SS-Electronics/KiCAD_DB/README.md

# KiCAD_DB
KiCAD Symbol and Footprint database.
