SS-Electronics/KiCAD_DB/3D/TS1117BCW50_RPG.step

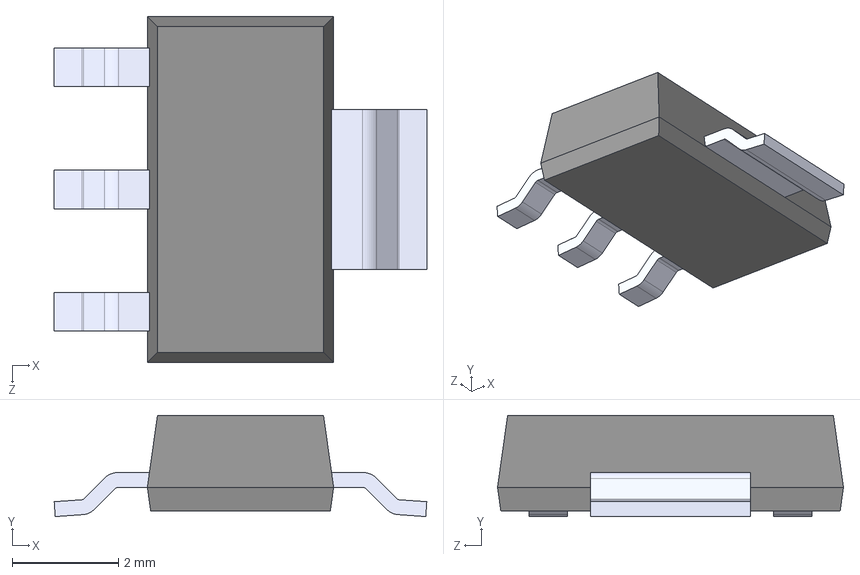
[picture p1: CAD file, 2025-02-05]
3D/TS1117BCW50_RPG.step
7.00 x 1.90 x 6.50 mm
