SS-Electronics/KiCAD_DB/3D/PCF8574ADWR.step

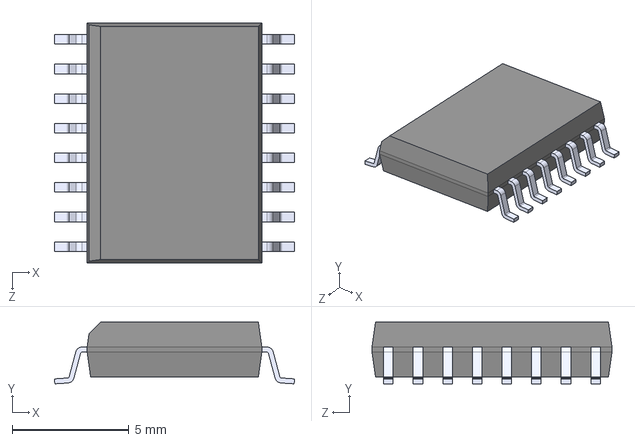
[picture p2: CAD file, 2025-02-03]
3D/PCF8574ADWR.step
10.3 x 2.65 x 10.3 mm
