SS-Electronics/KiCAD_DB/3D/G5LE-14 DC5.STEP

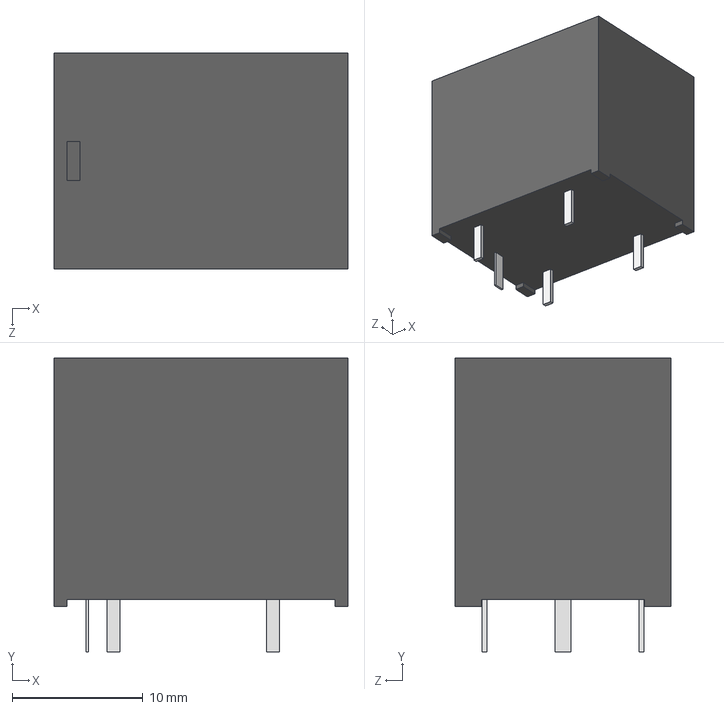
[picture p3: CAD file, 2025-02-03]
3D/G5LE-14 DC5.STEP
22.5 x 22.5 x 16.5 mm
