SS-Electronics/KiCAD_DB/3D/6120XX21621.step

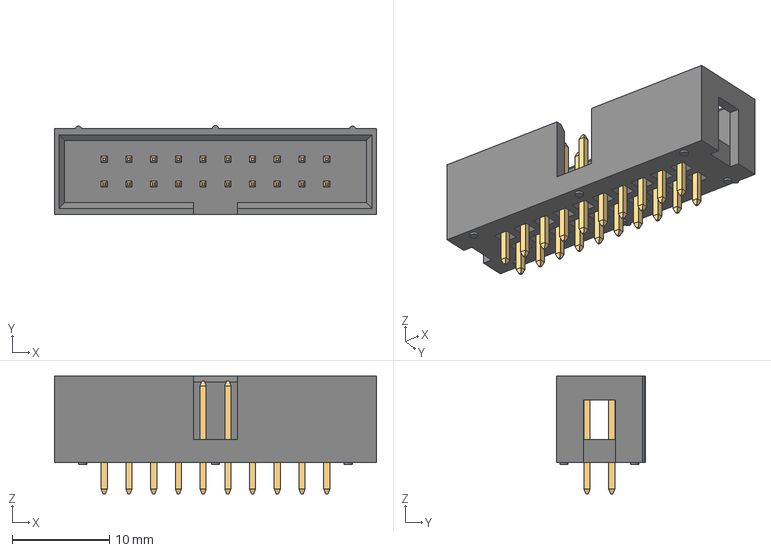
[picture p4: CAD file, 2025-02-01]
3D/6120XX21621.step
33.1 x 9.18 x 12.1 mm
6120xx21621_PIN x 20
