SS-Electronics/KiCAD_DB/3D/LM2576T-ADJ_NOPB.step

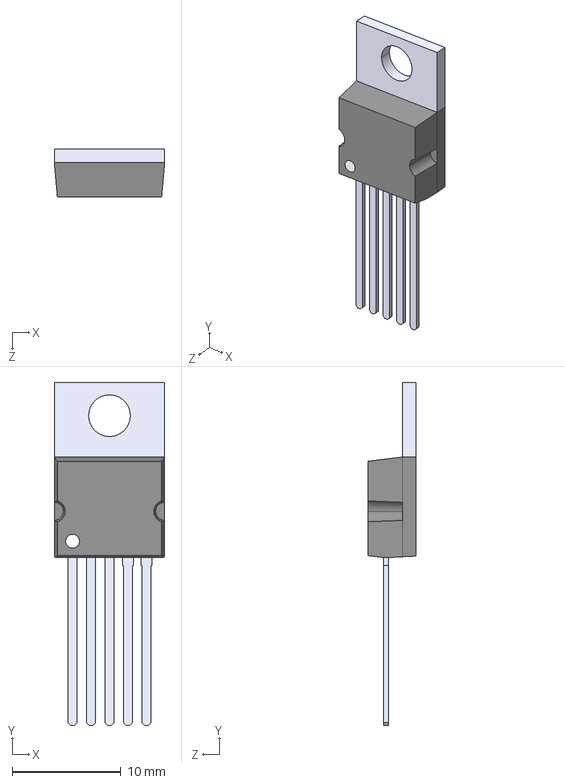
[picture p5: CAD file, 2025-01-29]
3D/LM2576T-ADJ_NOPB.step
10.2 x 31.6 x 4.45 mm
