SS-Electronics/KiCAD_DB/3D/PM2120-101K-RC.stp

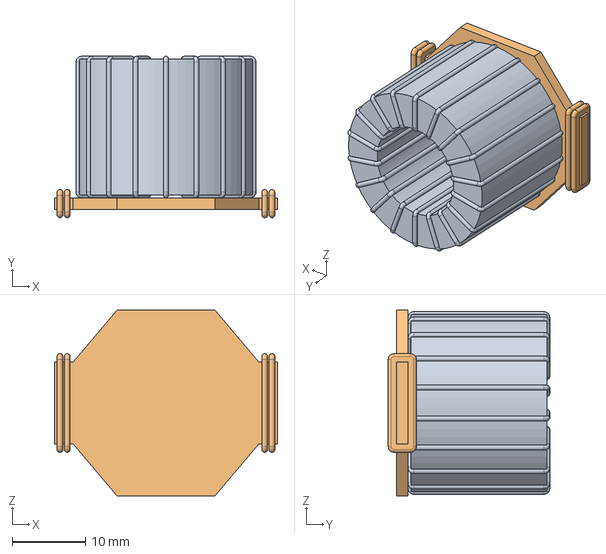
[picture p6: CAD file, 2025-01-29]
3D/PM2120-101K-RC.stp
30.5 x 22.1 x 25.4 mm
