SS-Electronics/KiCAD_DB/3D/7693.step

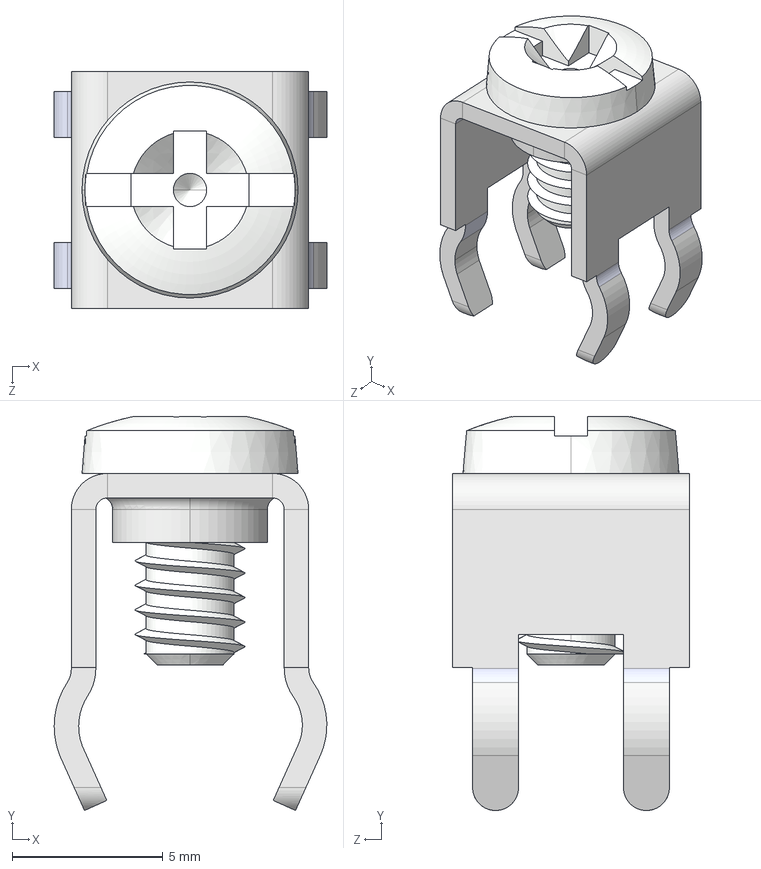
[picture p7: CAD file, 2025-01-29]
3D/7693.step
9.04 x 13.1 x 7.87 mm
