SS-Electronics/KiCAD_DB/3D/EEVFK1J471M.step

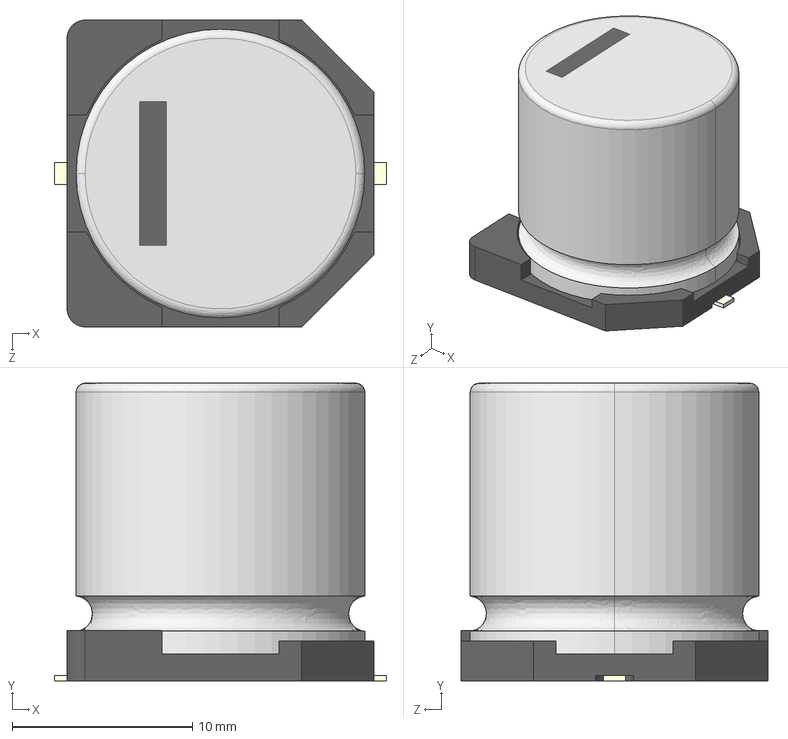
[picture p8: CAD file, 2025-01-29]
3D/EEVFK1J471M.step
18.4 x 16.5 x 17.0 mm
