SS-Electronics/KiCAD_DB/3D/PJ-002B.step

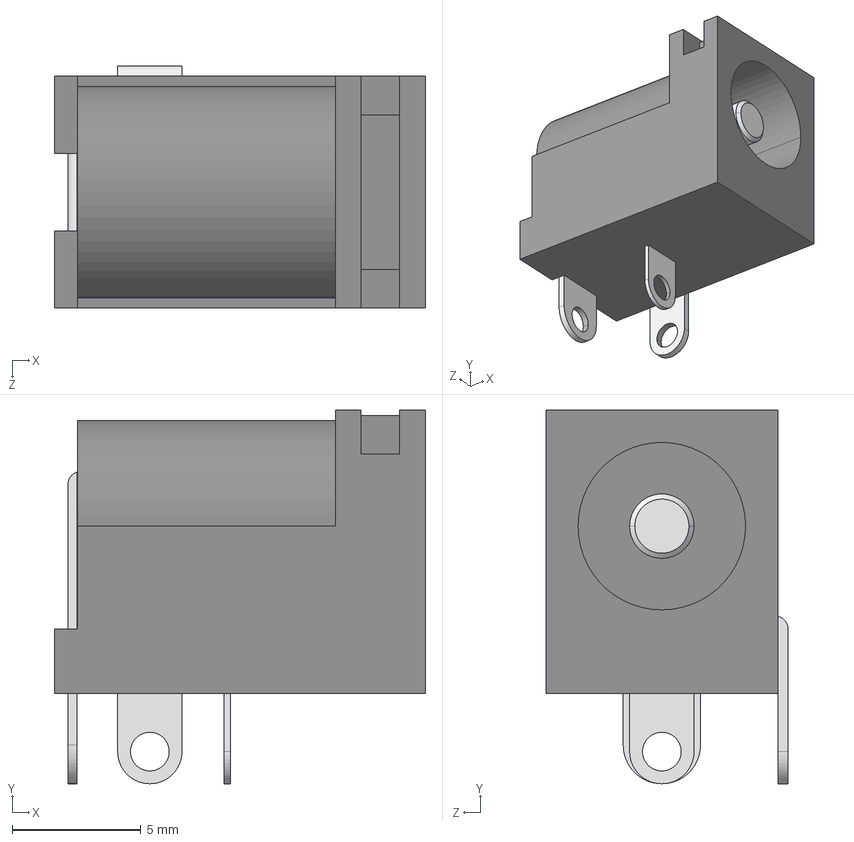
[picture p9: CAD file, 2025-01-29]
3D/PJ-002B.step
14.4 x 14.5 x 9.40 mm
