SS-Electronics/KiCAD_DB/3D/LF02.STEP

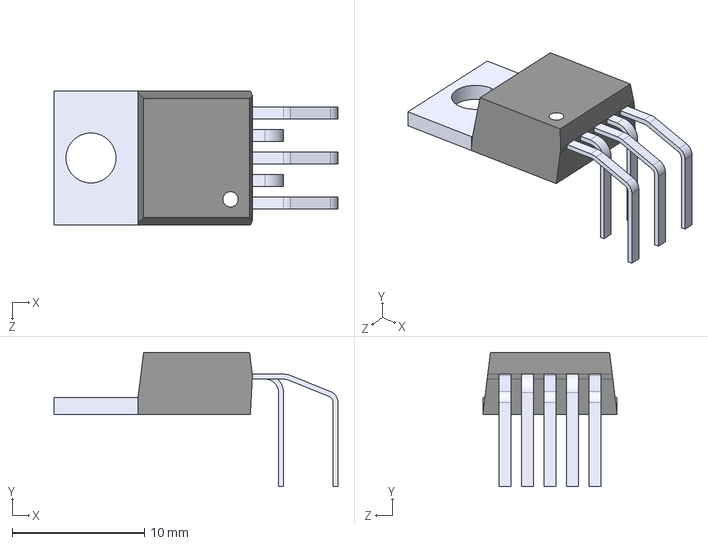
[picture p10: CAD file, 2025-01-29]
3D/LF02.STEP
21.5 x 10.2 x 10.2 mm
