SS-Electronics/KiCAD_DB/(commit log)

2022-10-23 ARDUINO_NANO Added
2025-01-29 Componnets added..
    [7693.step, EEVFK1J471M.step, LF02.STEP, LM2576T-ADJ_NOPB.step, PJ-002B.step, PM2120-101K-RC.stp]
2025-02-01 Connecor + MCU added
    [6120XX21621.step]
2025-02-03 Relay module added.
    [G5LE-14 DC5.STEP, PCF8574ADWR.step]
2025-02-03 feat: MagicPower V1.0 Components update.
    [7693.step, B550C-13-F.step, EEVFK1J471M.step, LF02.STEP, LM2576T-ADJ_NOPB.step, PJ-002B.step, PM2120-101K-RC.stp]
2025-02-05 feat: LDO added.
    [7693.step, B550C-13-F.step, EEVFK1J471M.step, LF02.STEP, LM2576T-ADJ_NOPB.step, PJ-002B.step, PM2120-101K-RC.stp, TS1117BCW50_RPG.step]
